sat-thu-da-tinh/PROJECT-Embedded-System-Design-EE3003/README.md

## BTL môn Thiết Kế Hệ Thống Nhúng (EE3003) - HK251 - HCMUT

#### Chủ Đề: bãi xe thông minh 

Thiết kế bãi xe thông minh xử dụng VXL Atmega328p, RFID NFC 13.56MHz RC552 

video mô hình hệ thống: https://drive.google.com/drive/folders/1X-8VSGQEHZhN04-JYkm2xYVY1bG1itku
