sat-thu-da-tinh/PROJECT-Embedded-System-Design-EE3003/(list of files, drawings)

Other design files:
mạch hoàn chỉnh.SchDoc
